Xinyuan-LilyGO/T3-S3-MVSRBoard/project/T3-S3-MVSRBoard_V1.1.pdf

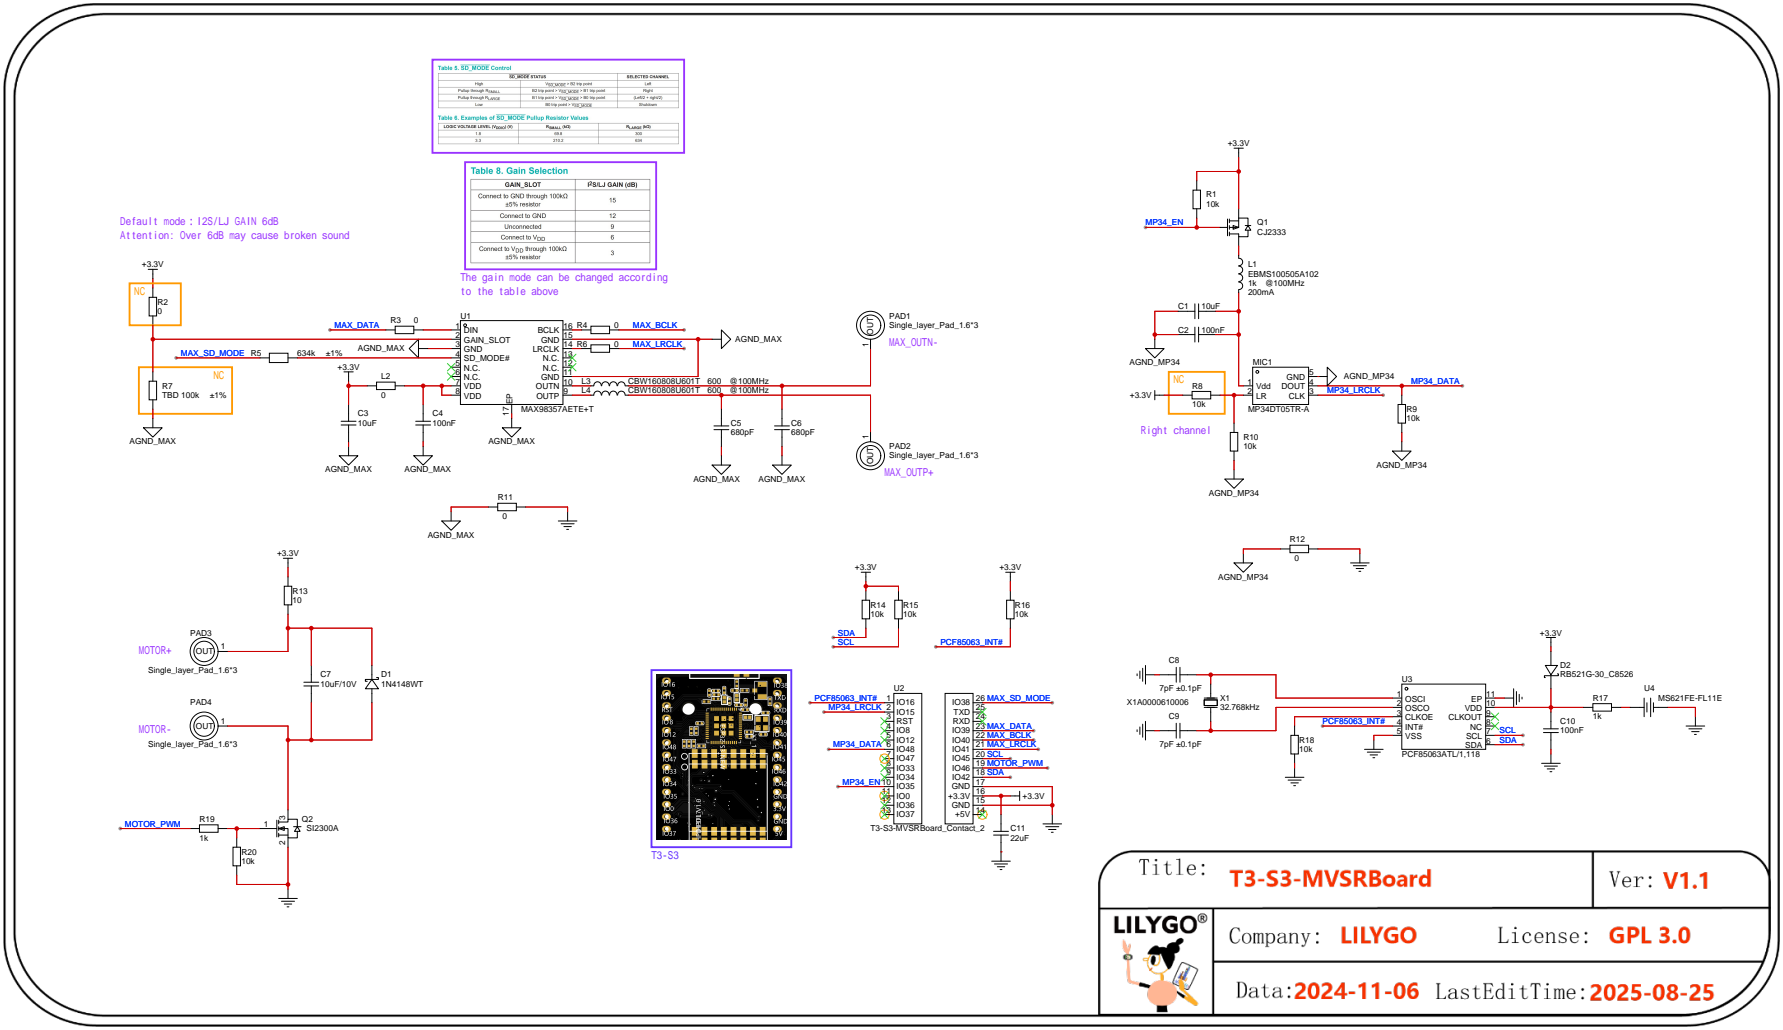
[picture p16: page 1]

Default mode：I2S/LJ GAIN 6dB
Attention: Over 6dB may cause broken sound

The gain mode can be changed according
to the table above

OUTN 10 GND 11 N.C. 12 N.C. 13 LRCLK 14 GND 15 BCLK 16
