Xinyuan-LilyGO/T3-S3-MVSRBoard/examples/PCF85063_Timer_INT/PCF85063_Timer_INT.ino

/*
 * @Description: 
            PCF85063 timer triggers interrupt
 * @Author: LILYGO_L
 * @Date: 2024-03-27 10:02:26
 * @LastEditTime: 2025-02-05 17:05:03
 * @License: GPL 3.0
 */

#include "Arduino_DriveBus_Library.h"
#include "pin_config.h"

std::shared_ptr<Arduino_IIC_DriveBus> IIC_Bus =
    std::make_shared<Arduino_HWIIC>(IIC_SDA, IIC_SCL, &Wire);

void Arduino_IIC_Touch_Interrupt(void);

std::unique_ptr<Arduino_IIC> PCF85063(new Arduino_PCF85063(IIC_Bus, PCF85063_DEVICE_ADDRESS,
                                                           DRIVEBUS_DEFAULT_VALUE, PCF85063_INT, Arduino_IIC_Touch_Interrupt));

void Arduino_IIC_Touch_Interrupt(void)
{
    PCF85063->IIC_Interrupt_Flag = true;
}

void setup()
{
    Serial.begin(115200);
    Serial.println("Ciallo");

    while (PCF85063->begin() == false)
    {
        Serial.println("PCF85063 initialization fail");
        delay(2000);
    }
    Serial.println("PCF85063 initialization successfully");

    // Software Reset
    PCF85063->IIC_Device_Reset();

    // 关闭时钟输出
    PCF85063->IIC_Write_Device_State(PCF85063->Arduino_IIC_RTC::Device::RTC_CLOCK_OUTPUT_VALUE,
                                     PCF85063->Arduino_IIC_RTC::Device_Mode::RTC_CLOCK_OUTPUT_OFF);

    // 设置时间格式为24小时制
    PCF85063->IIC_Write_Device_State(PCF85063->Arduino_IIC_RTC::Device::RTC_CLOCK_TIME_FORMAT,
                                     PCF85063->Arduino_IIC_RTC::Device_Mode::RTC_CLOCK_TIME_FORMAT_24);

    // 关闭定时器
    PCF85063->IIC_Write_Device_State(PCF85063->Arduino_IIC_RTC::Device::RTC_TIMER,
                                     PCF85063->Arduino_IIC_RTC::Device_State::RTC_DEVICE_OFF);

    // 清除定时器标志TF
    PCF85063->IIC_Write_Device_Value(PCF85063->Arduino_IIC_RTC::Device_Value::RTC_TIMER_FLAG_TF,
                                     0);
    // 下面设定10秒定时
    //  设置定时器频率的值为1Hz（选择的频率越高越精准）
    PCF85063->IIC_Write_Device_State(PCF85063->Arduino_IIC_RTC::Device::RTC_TIMER_FREQUENCY_VALUE,
                                     PCF85063->Arduino_IIC_RTC::Device_Mode::RTC_TIMER_FREQUENCY_1);
    // 设置定时器的n值（定时器定时周期的时间=定时器的n值/定时器频率）
    PCF85063->IIC_Write_Device_Value(PCF85063->Arduino_IIC_RTC::Device_Value::RTC_TIMER_N_VALUE,
                                     10);

    // 开启定时中断
    PCF85063->IIC_Write_Device_State(PCF85063->Arduino_IIC_RTC::Device::RTC_INT_TIE,
                                     PCF85063->Arduino_IIC_RTC::Device_State::RTC_DEVICE_ON);

    // 开启定时器
    PCF85063->IIC_Write_Device_State(PCF85063->Arduino_IIC_RTC::Device::RTC_TIMER,
                                     PCF85063->Arduino_IIC_RTC::Device_State::RTC_DEVICE_ON);

    Serial.printf("ID: %#X \n\n", (int32_t)PCF85063->IIC_Device_ID());

    Serial.println("10 second timer starts");
}

void loop()
{
    if (PCF85063->IIC_Interrupt_Flag == true)
    {
        PCF85063->IIC_Interrupt_Flag = false;
        if ((int32_t)PCF85063->IIC_Read_Device_Value(PCF85063->Arduino_IIC_RTC::Value_Information::RTC_TIMER_FLAG_TF_INFORMATION) == 1)
        {
            Serial.println("RTC_TIMER_FLAG_TF_INFORMATION triggered");

            // 清除定时器标志TF
            PCF85063->IIC_Write_Device_Value(PCF85063->Arduino_IIC_RTC::Device_Value::RTC_TIMER_FLAG_TF,
                                             0);
        }
        delay(1000);
    }
}
