Xinyuan-LilyGO/T3-S3-MVSRBoard/(commit log)

2025-05-19 Fix Arduino configuration #2
2025-08-25 update Arduino_DriveBus
2025-12-23 fixed arduino partition error #8
